TAPR/TAPRx888/(notices)

Notices in the files:
parts and their libraries:
LICENSE: MIT
